marqaantwerpen-droid/printrekenmachine/robot/cad/stl/femur.stl

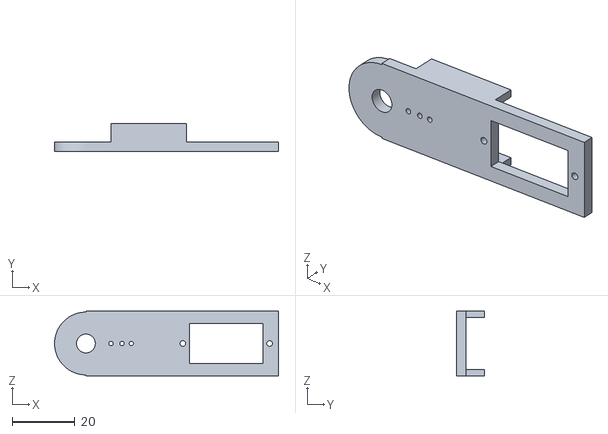
[picture p1: CAD file, 2026-10-26]
robot/cad/stl/femur.stl
71.3 x 9.00 x 20.7
