marqaantwerpen-droid/printrekenmachine/robot/cad/stl/tibia.stl

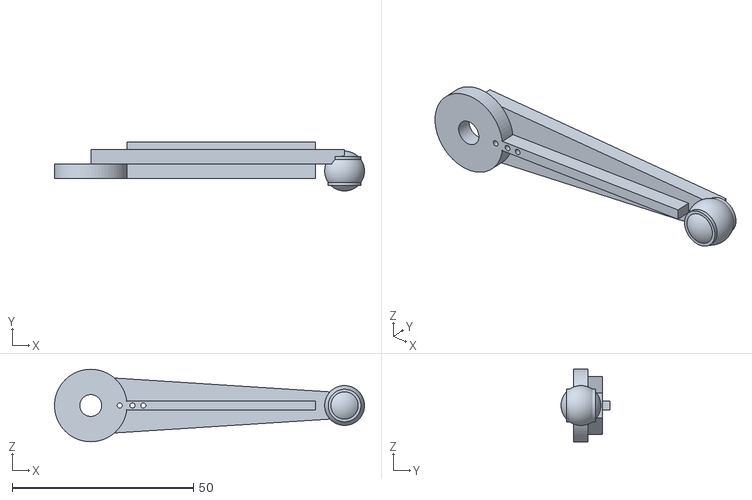
[picture p2: CAD file, 2026-10-26]
robot/cad/stl/tibia.stl
85.5 x 13.5 x 20.0
