marqaantwerpen-droid/printrekenmachine/robot/cad/stl/coxa_bracket.stl

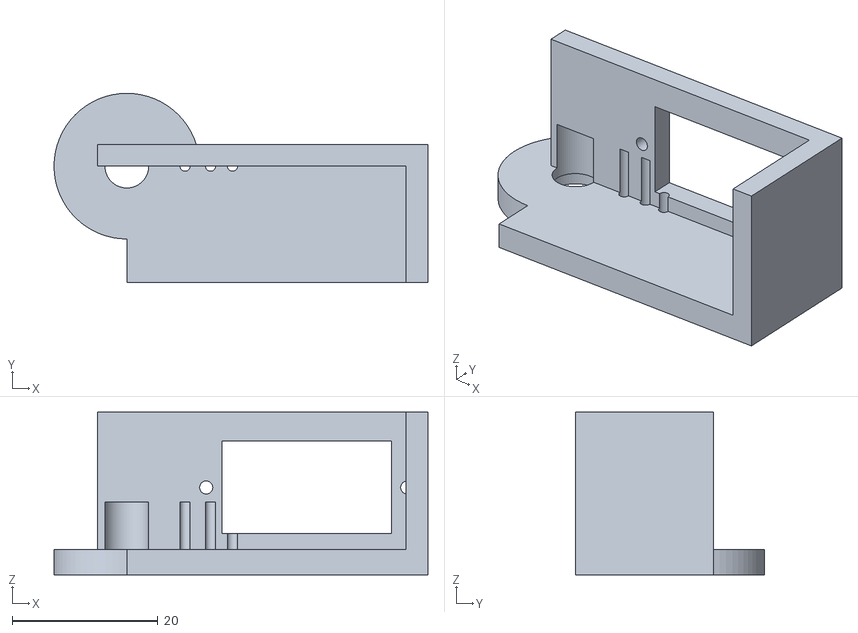
[picture p3: CAD file, 2026-10-26]
robot/cad/stl/coxa_bracket.stl
51.3 x 26.0 x 22.4
