marqaantwerpen-droid/printrekenmachine/robot/cad/stl/lid.stl

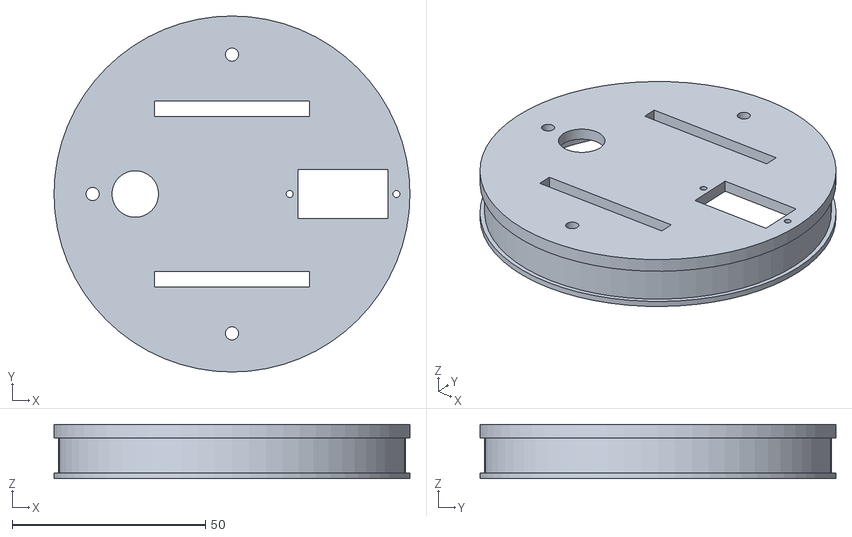
[picture p4: CAD file, 2026-10-26]
robot/cad/stl/lid.stl
92.0 x 92.0 x 14.0
