marqaantwerpen-droid/printrekenmachine/robot/cad/stl/head_bracket.stl

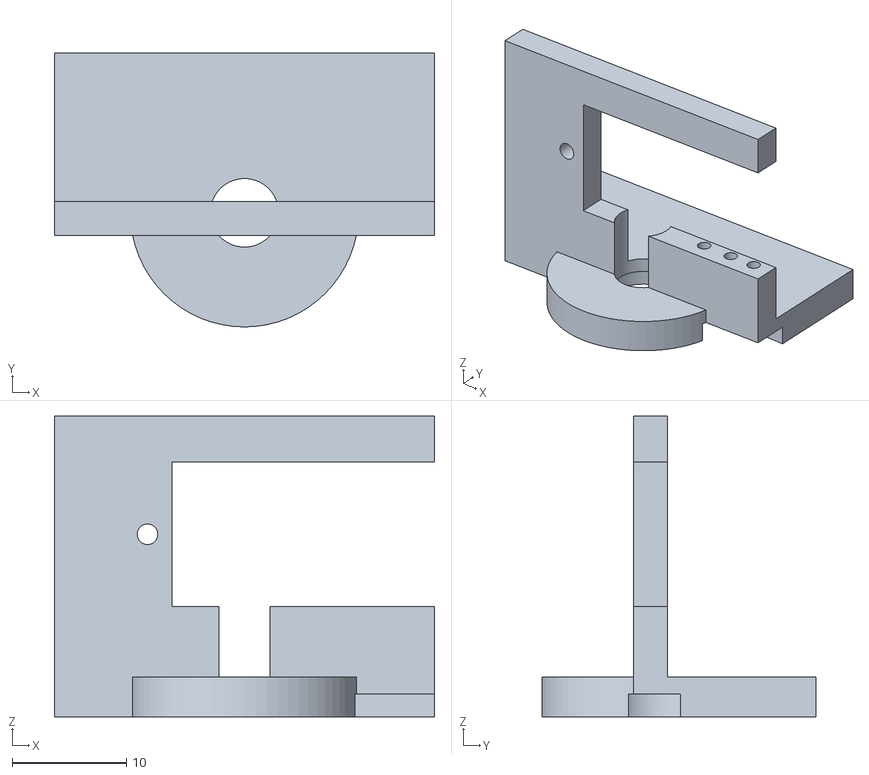
[picture p5: CAD file, 2026-10-26]
robot/cad/stl/head_bracket.stl
33.3 x 24.0 x 26.4
