marqaantwerpen-droid/printrekenmachine/robot/cad/stl/chassis.stl

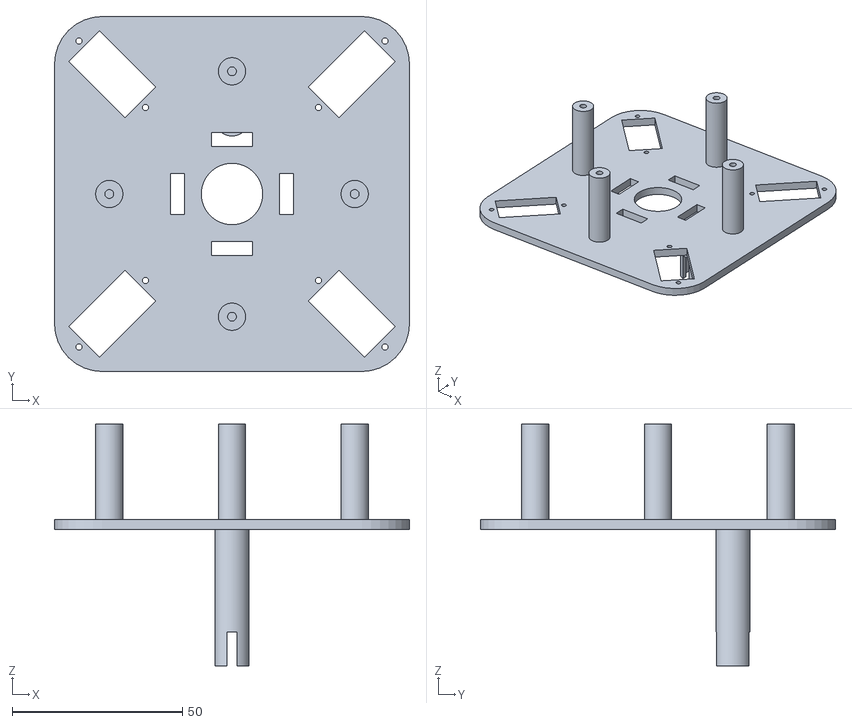
[picture p6: CAD file, 2026-10-26]
robot/cad/stl/chassis.stl
104.2 x 104.2 x 71.0
