marqaantwerpen-droid/printrekenmachine/robot/cad/stl/dock.stl

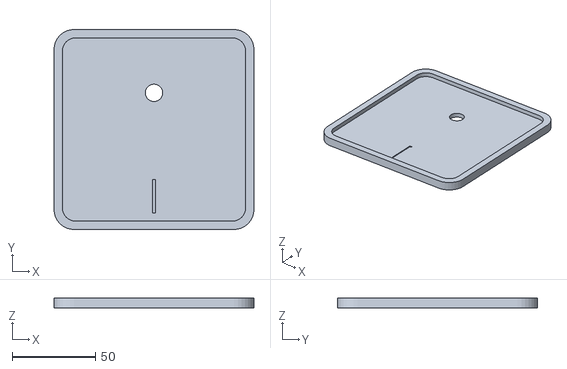
[picture p7: CAD file, 2026-10-26]
robot/cad/stl/dock.stl
120.0 x 120.0 x 6.00
