marqaantwerpen-droid/printrekenmachine/robot/cad/stl/head_shell.stl

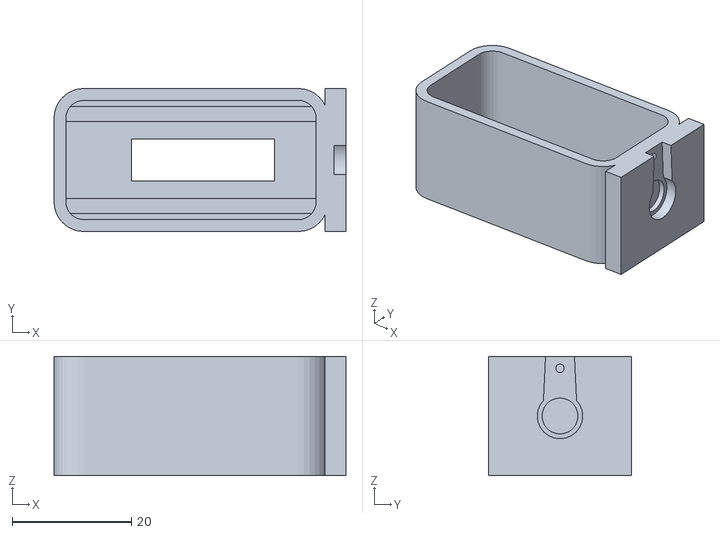
[picture p8: CAD file, 2026-10-26]
robot/cad/stl/head_shell.stl
49.0 x 24.0 x 20.0
