marqaantwerpen-droid/printrekenmachine/robot/cad/stl/foot_cap_TPU.stl

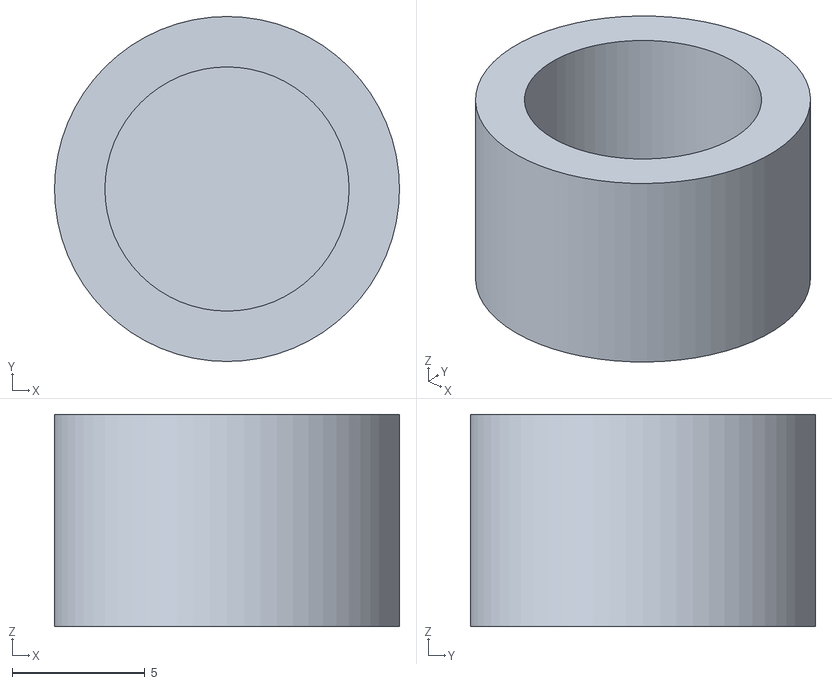
[picture p9: CAD file, 2026-10-26]
robot/cad/stl/foot_cap_TPU.stl
13.0 x 13.0 x 8.00
