marqaantwerpen-droid/printrekenmachine/robot/firmware/src/secrets.example.h

// Kopieer naar secrets.h en vul je eigen WiFi in. secrets.h wordt niet gecommit.
#pragma once
#define WIFI_SSID     "JouwWiFi"
#define WIFI_PASSWORD "JouwWachtwoord"
// Optioneel: API-sleutel. Leeg = geen sleutel nodig (alleen thuisnetwerk!).
#define API_KEY       ""
