marqaantwerpen-droid/printrekenmachine/(commit log)

2026-06-16 Printrekenmachine — landing + privacy policy
2026-10-26 SPIN: vierpotige WiFi-robot (ESP32-firmware, printbare onderdelen, bediening)
    - Firmware (PlatformIO): inverse kinematica, drafgang, JSON-API, webpagina,
    OLED-gezicht, WS2812B-leds, hall-sensor, aanleerbare moves in LittleFS, OTA
    - CAD: spin_parts.py genereert alle STL's (chassis, deksel, poten, hoofd, dock)
    - tools/spin.py: bediening vanaf de commandoregel
    - CLAUDE.md: instructies om de robot via Claude Code te besturen
    Claude-Session: https://claude.ai/code/session_014ohZvvFKkmFUdYFhUcPUEm
    [chassis.stl, coxa_bracket.stl, dock.stl, femur.stl, foot_cap_TPU.stl, head_bracket.stl, head_shell.stl, lid.stl]
2026-10-26 Firmware: ondersteuning voor het PCBWay/regishsu SG90-spinframe (standaard)
    Heuppositie en neutrale heuprichting zijn nu losse instellingen, zodat ook
    frames met heupen die opzij wijzen werken. Maten van het geprinte frame in
    config.h; README beschrijft wat je moet nameten en controleren.
    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
